TimMJN/Arduino-Euclidean-Rhythm-Generator/images/render_back.png

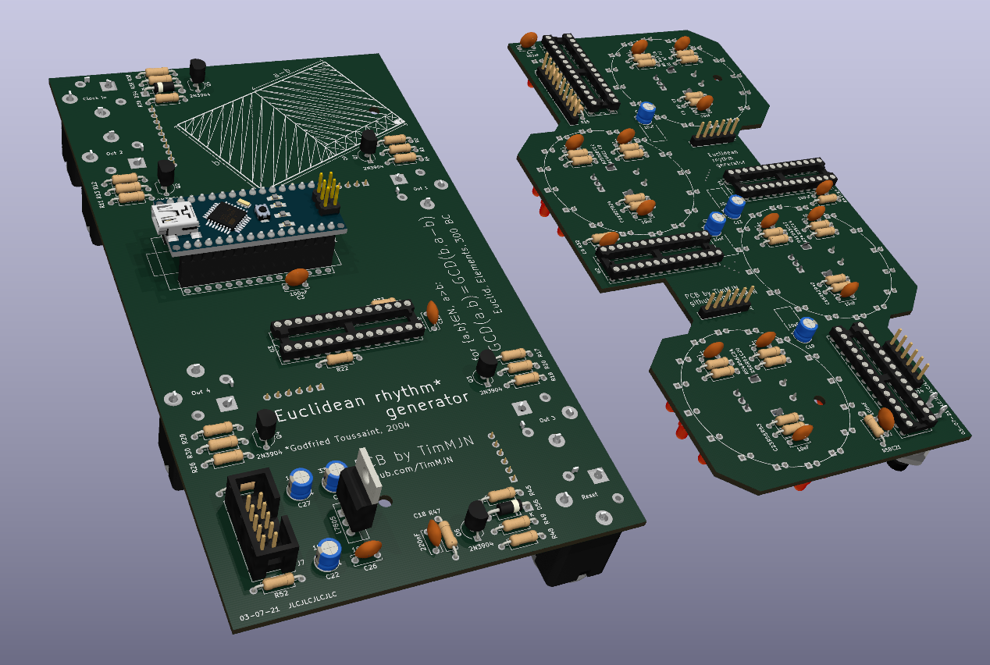
images/render_back.png
