TimMJN/Arduino-Euclidean-Rhythm-Generator/images/render_cv_expander_front.png

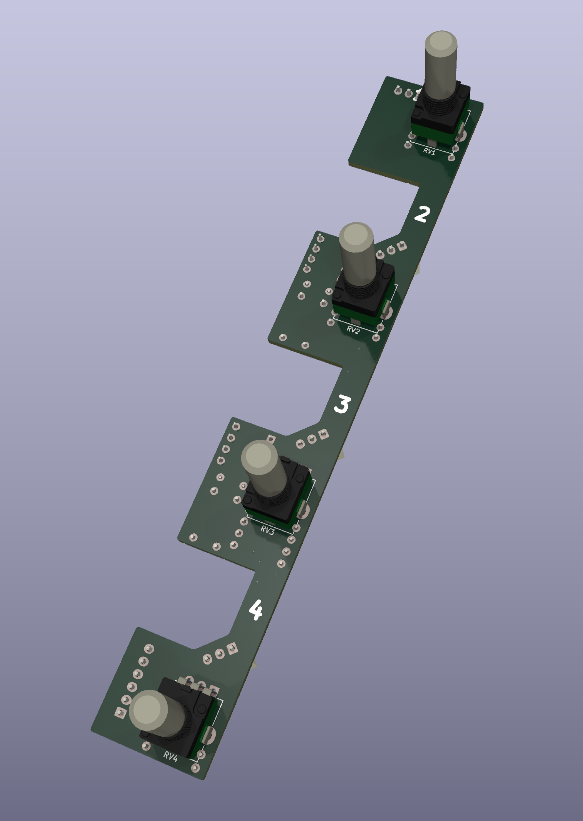
images/render_cv_expander_front.png
