TimMJN/Arduino-Euclidean-Rhythm-Generator/images/render_cv_expander_back.png

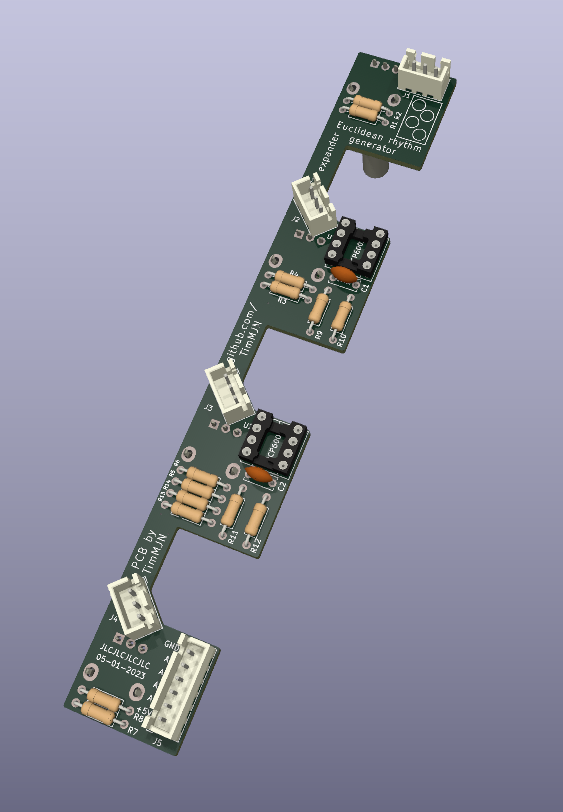
images/render_cv_expander_back.png
