TimMJN/Arduino-Euclidean-Rhythm-Generator/images/render_front.png

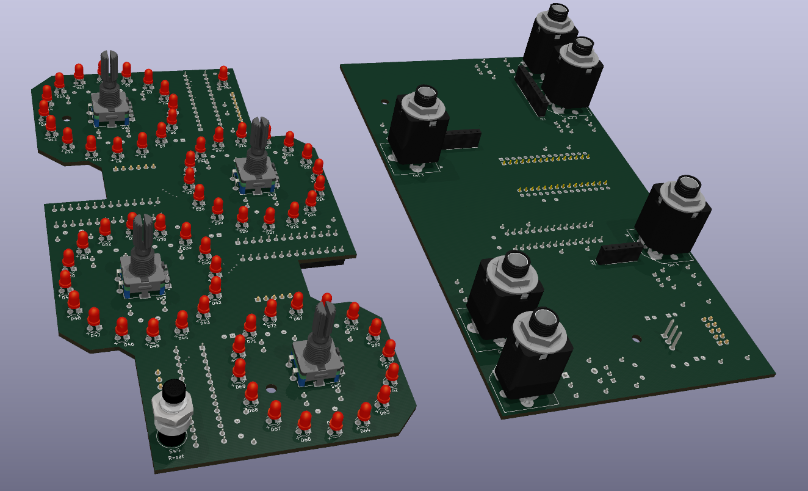
images/render_front.png
