TimMJN/Arduino-Euclidean-Rhythm-Generator/PCB/arduino_euclidean_rhythm_generator-PCB_back.png

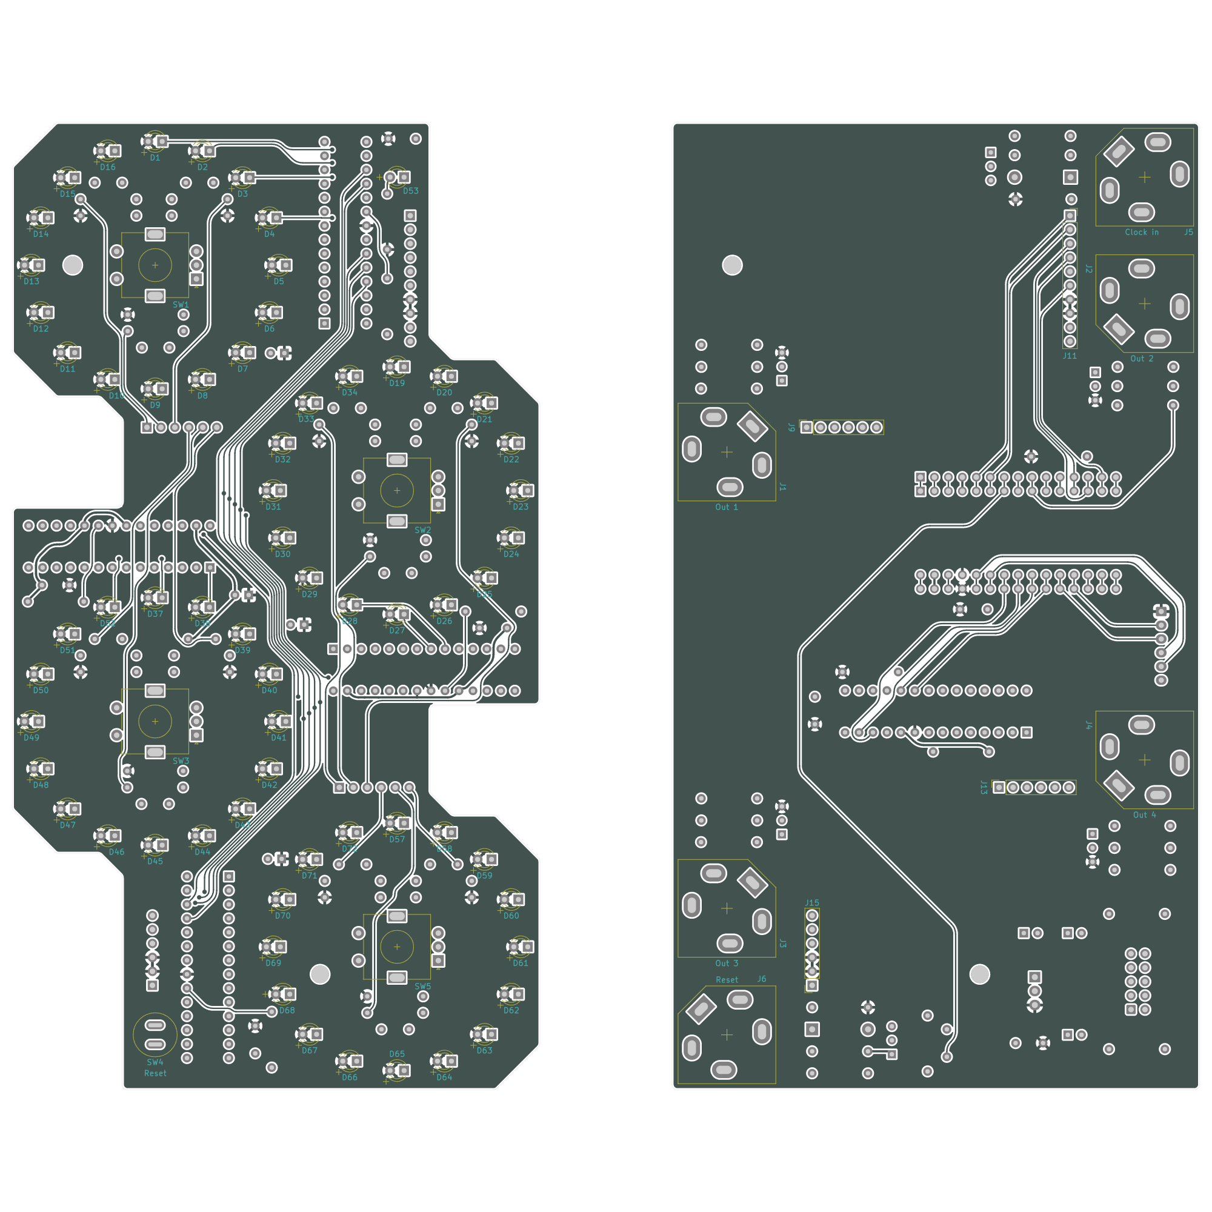
PCB/arduino_euclidean_rhythm_generator-PCB_back.png
