TimMJN/Arduino-Euclidean-Rhythm-Generator/PCB/arduino_euclidean_rhythm_generator-PCB_front.png

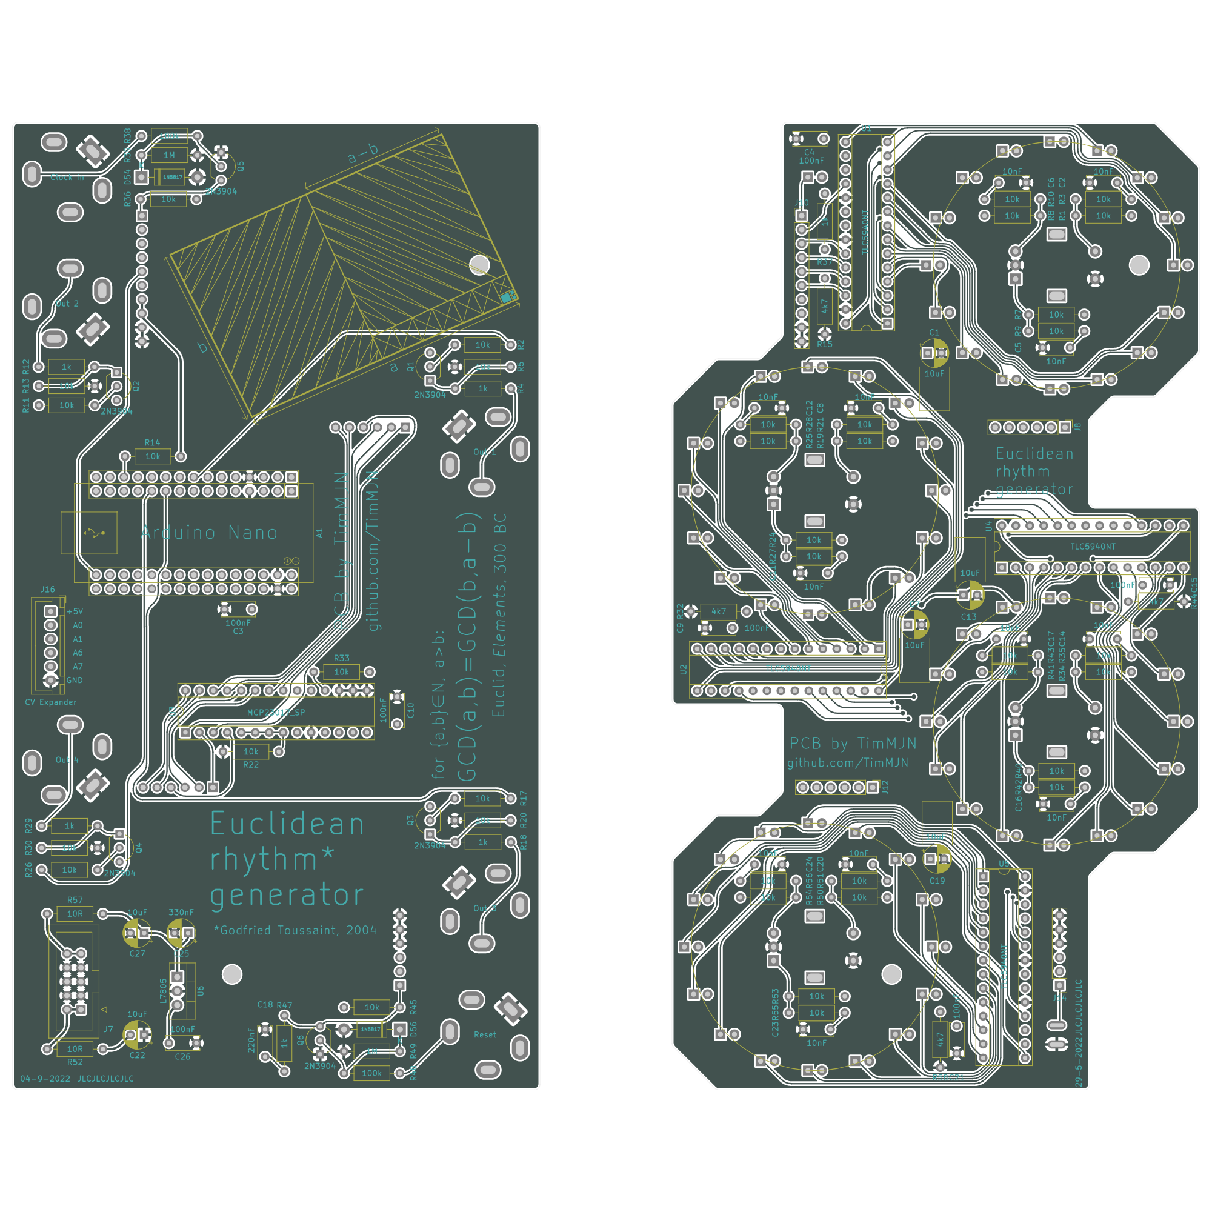
PCB/arduino_euclidean_rhythm_generator-PCB_front.png
