TimMJN/Arduino-Euclidean-Rhythm-Generator/schematic+BOM/arduino_euclidean_rhythm_generator.pdf

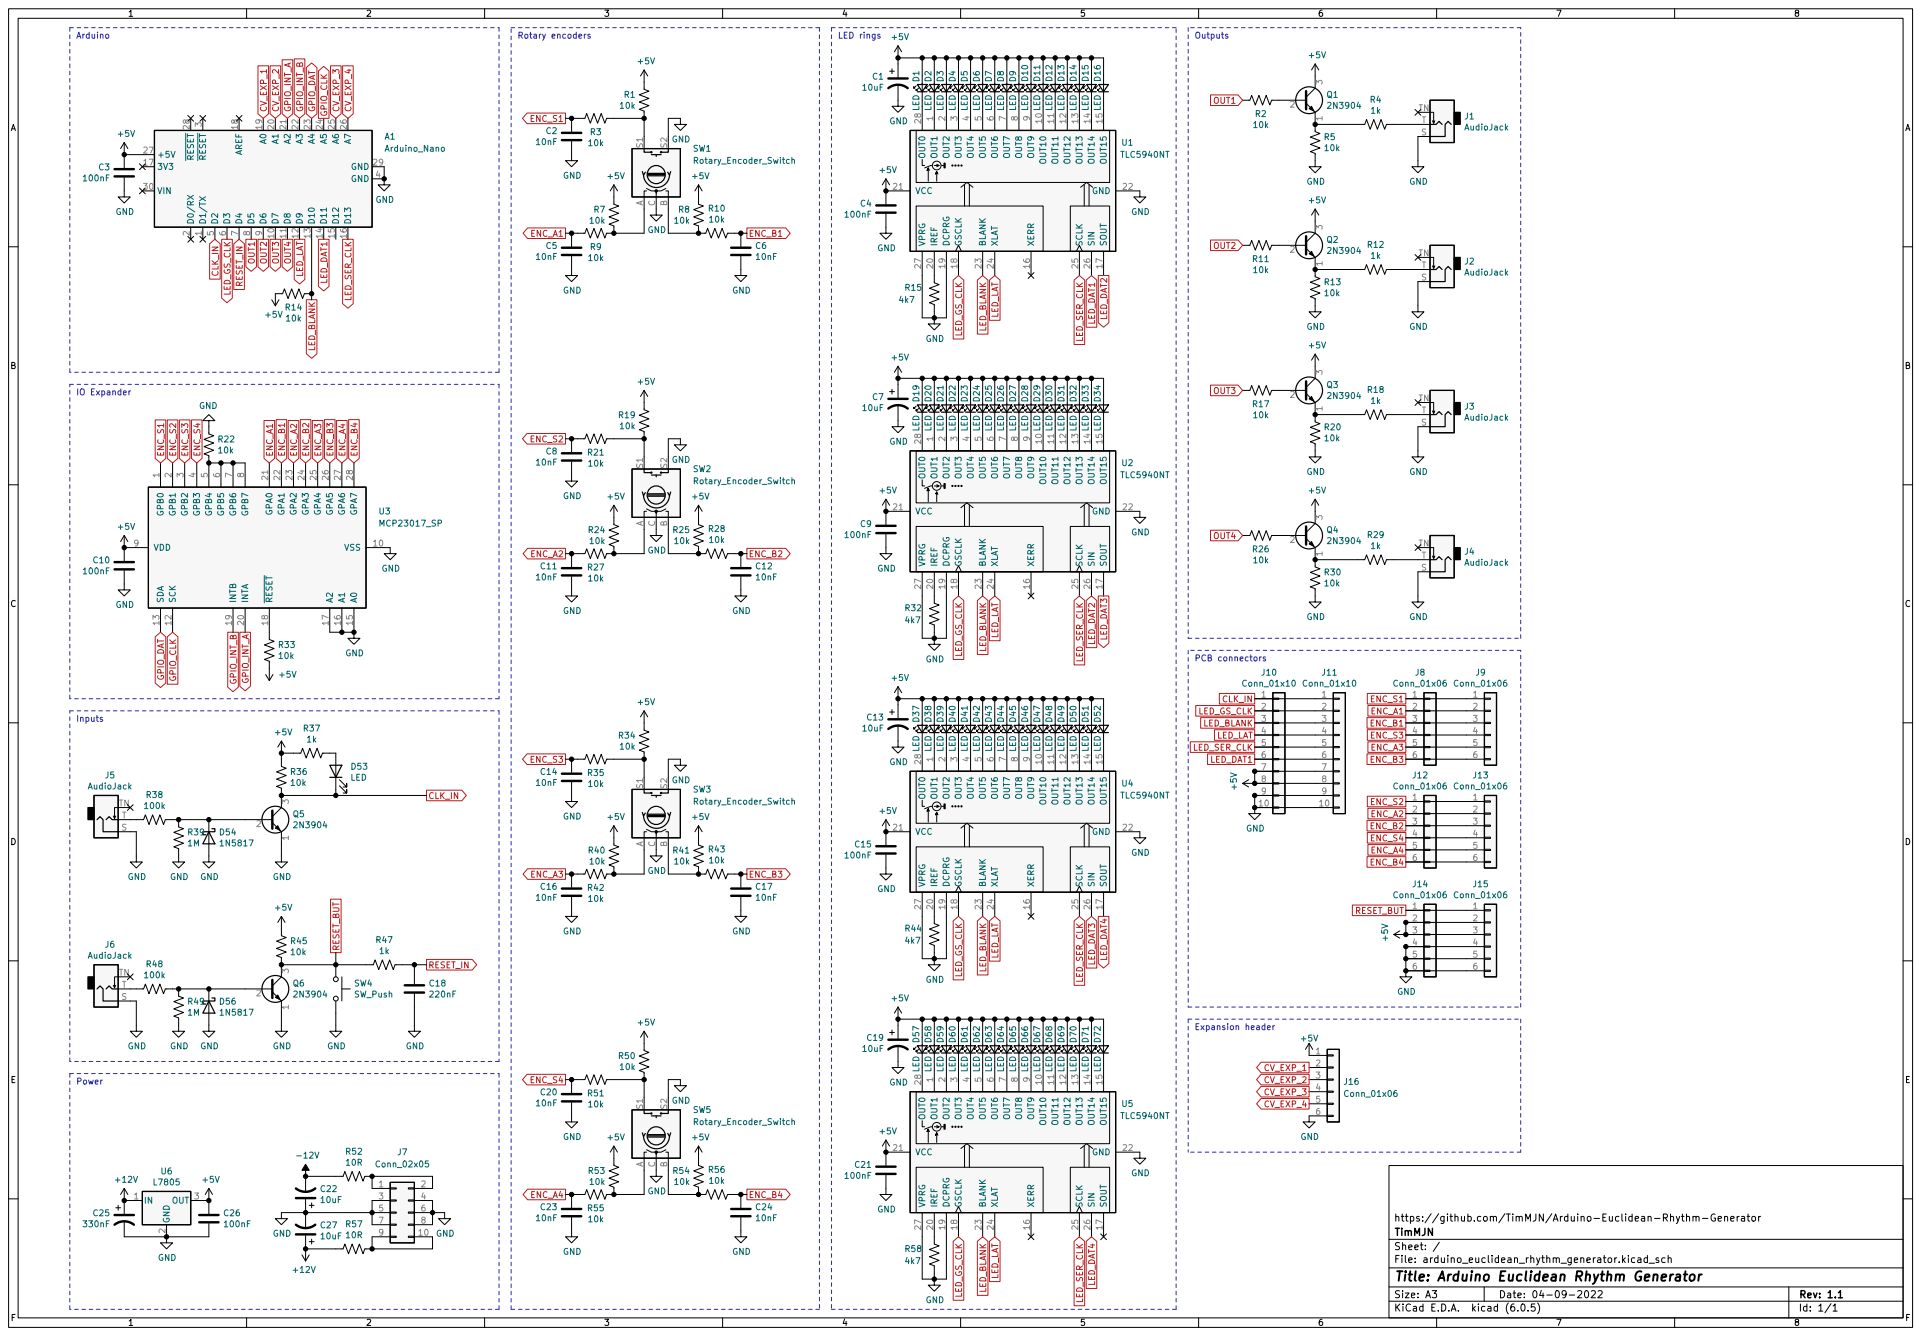
[picture p8: page 1]

https://github.com/TimMJN/Arduino-Euclidean-Rhythm-Generator
File: arduino_euclidean_rhythm_generator.kicad_sch Sheet: / TimMJN

Id: 1/1 Title: Arduino Euclidean Rhythm Generator
