TimMJN/Arduino-Euclidean-Rhythm-Generator/schematic+BOM/arduino_euclidean_rhythm_generator_BOM.pdf

Euclidean Rhythm Generator | Rev: 1.1
TimMJN | 04-09-2022

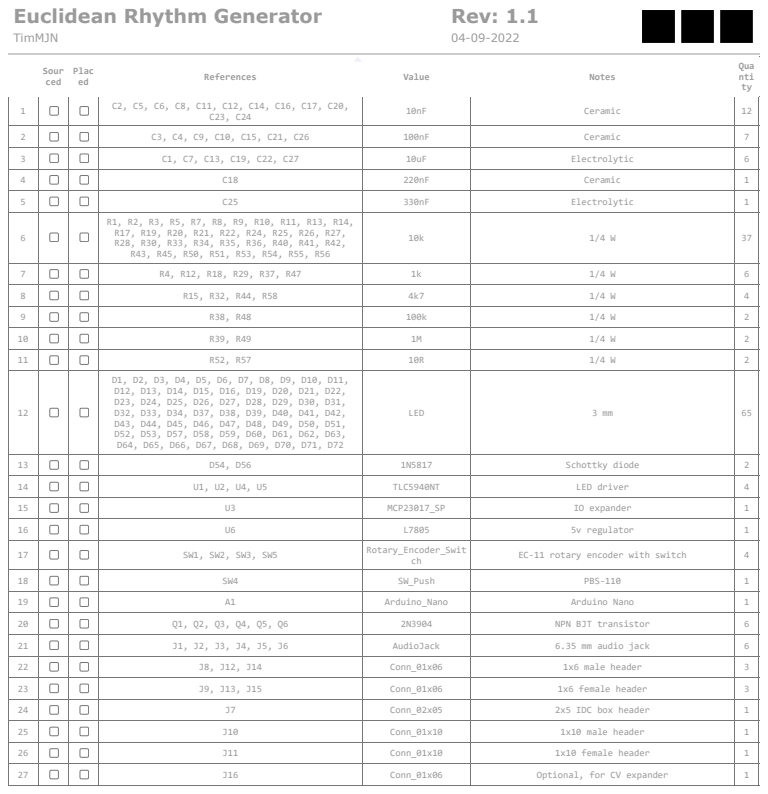
[picture p9: page 1]

Sour ced | Plac ed | References | Value | Notes | Qua nti ty

1 | | | C2, C5, C6, C8, C11, C12, C14, C16, C17, C20, C23, C24 | 10nF | Ceramic | 12

2 | | | C3, C4, C9, C10, C15, C21, C26 | 100nF | Ceramic | 7

3 | | | C1, C7, C13, C19, C22, C27 | 10uF | Electrolytic | 6

4 | | | C18 | 220nF | Ceramic | 1

5 | | | C25 | 330nF | Electrolytic | 1
6 | | | R1, R2, R3, R5, R7, R8, R9, R10, R11, R13, R14, R17, R19, R20, R21, R22, R24, R25, R26, R27, R28, R30, R33, R34, R35, R36, R40, R41, R42, R43, R45, R50, R51, R53, R54, R55, R56 | 10k | 1/4 W | 37

11 | | | R52, R57 | 10R | 1/4 W | 2
12 | | | D1, D2, D3, D4, D5, D6, D7, D8, D9, D10, D11, D12, D13, D14, D15, D16, D19, D20, D21, D22, D23, D24, D25, D26, D27, D28, D29, D30, D31, D32, D33, D34, D37, D38, D39, D40, D41, D42, D43, D44, D45, D46, D47, D48, D49, D50, D51, D52, D53, D57, D58, D59, D60, D61, D62, D63, D64, D65, D66, D67, D68, D69, D70, D71, D72 | LED | 3 mm | 65

13 | | | D54, D56 | 1N5817 | Schottky diode | 2

14 | | | U1, U2, U4, U5 | TLC5940NT | LED driver | 4

15 | | | U3 | MCP23017_SP | IO expander | 1

16 | | | U6 | L7805 | 5v regulator | 1
17 | | | SW1, SW2, SW3, SW5 | Rotary_Encoder_Swit ch | EC-11 rotary encoder with switch | 4

18 | | | SW4 | SW_Push | PBS-110 | 1

19 | | | A1 | Arduino_Nano | Arduino Nano | 1

20 | | | Q1, Q2, Q3, Q4, Q5, Q6 | 2N3904 | NPN BJT transistor | 6

21 | | | J1, J2, J3, J4, J5, J6 | AudioJack | 6.35 mm audio jack | 6

22 | | | J8, J12, J14 | Conn_01x06 | 1x6 male header | 3

23 | | | J9, J13, J15 | Conn_01x06 | 1x6 female header | 3

24 | | | J7 | Conn_02x05 | 2x5 IDC box header | 1

25 | | | J10 | Conn_01x10 | 1x10 male header | 1

26 | | | J11 | Conn_01x10 | 1x10 female header | 1

27 | | | J16 | Conn_01x06 | Optional, for CV expander | 1
