TimMJN/Arduino-Euclidean-Rhythm-Generator/schematic+BOM/arduino_euclidean_rhythm_generator_cv_expander_BOM.pdf

# Euclidean Rhythm Generator CV Expa… Rev: 1.1

TimMJN | 05-01-2023

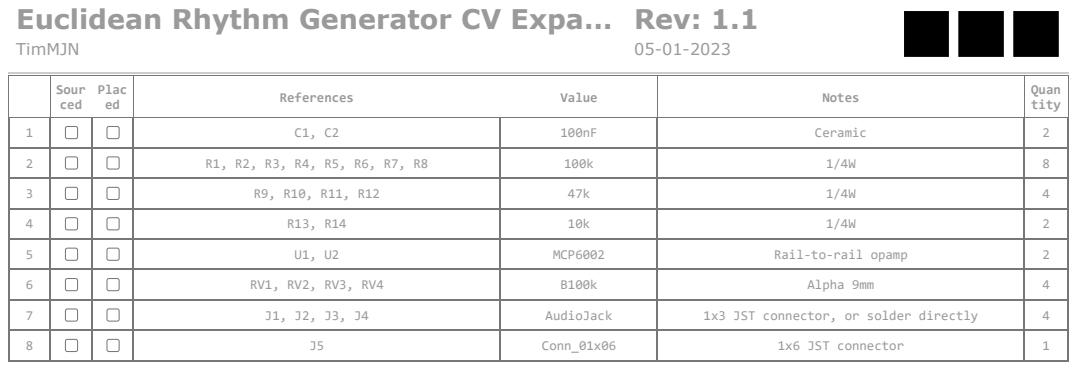
[picture p10: page 1]

Sour ced | Plac ed | References | Value | Notes | Quan tity

1 | | | C1, C2 | 100nF | Ceramic | 2

5 | | | U1, U2 | MCP6002 | Rail-to-rail opamp | 2

6 | | | RV1, RV2, RV3, RV4 | B100k | Alpha 9mm | 4

7 | | | J1, J2, J3, J4 | AudioJack | 1x3 JST connector, or solder directly | 4

8 | | | J5 | Conn_01x06 | 1x6 JST connector | 1
