TimMJN/Arduino-Euclidean-Rhythm-Generator/PCB/arduino_euclidean_rhythm_generator-Panel_drillguide.pdf

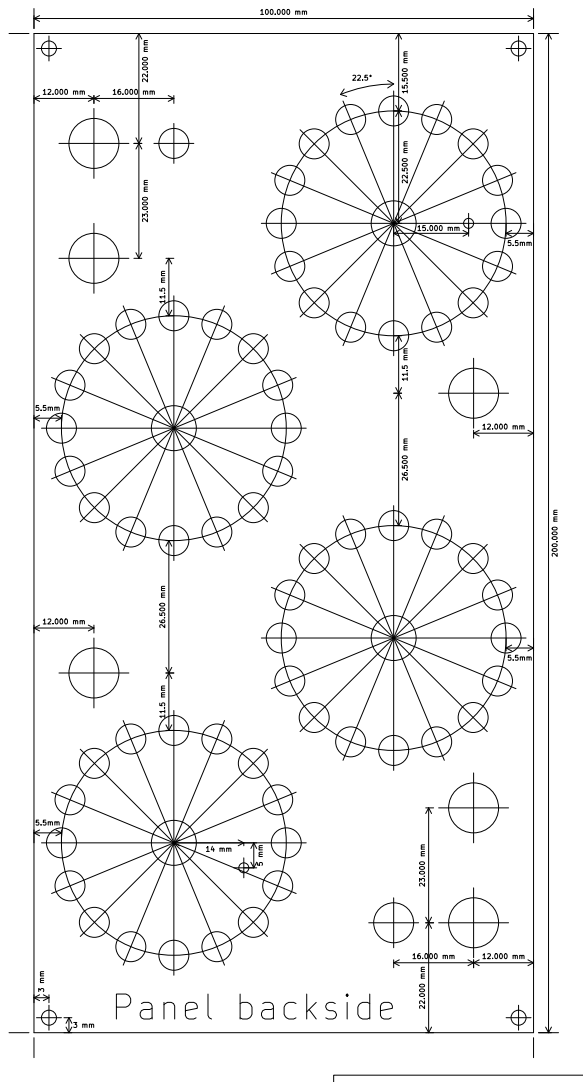
[picture p11: page 1]

github.com/TimMJN 3 mm

Id: 1/1 Title: Euclidean Rhythm Generator
