TimMJN/Arduino-Euclidean-Rhythm-Generator/PCB/arduino_euclidean_rhythm_generator_CV_expander-Panel_drillguide.pdf

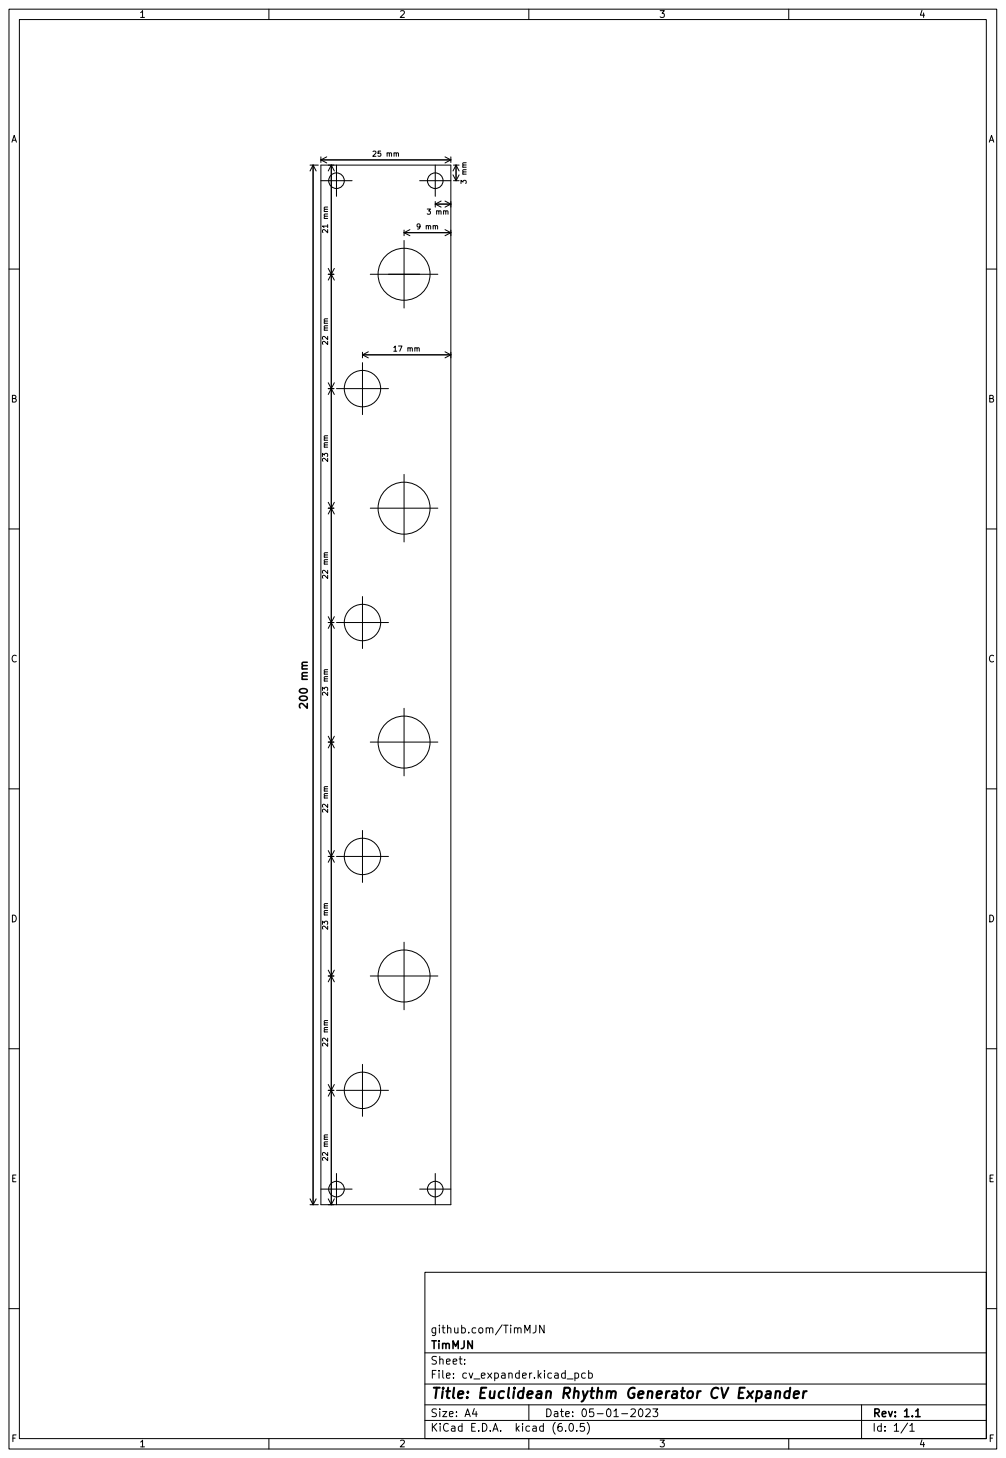
[picture p12: page 1]

Id: 1/1 Title: Euclidean Rhythm Generator CV Expander
