TimMJN/Arduino-Euclidean-Rhythm-Generator/schematic+BOM/arduino_euclidean_rhythm_generator_cv_expander.pdf

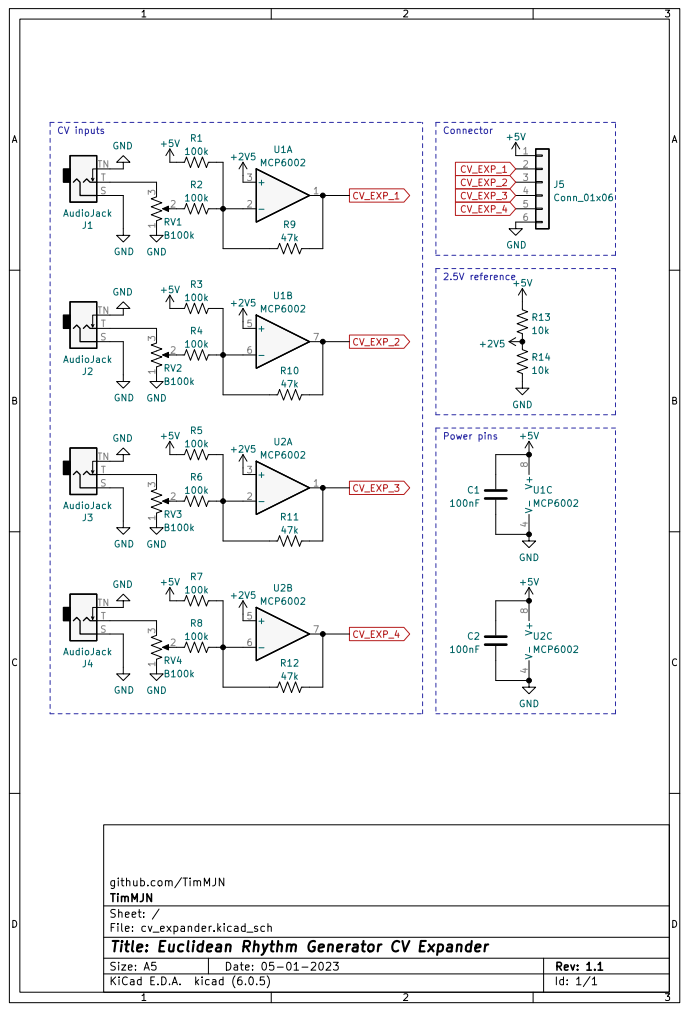
[picture p13: page 1]

Id: 1/1 Title: Euclidean Rhythm Generator CV Expander
