TimMJN/Arduino-Euclidean-Rhythm-Generator/(commit log)

2021-06-19 schematic update
2021-06-19 Update Adafruit-MCP23017-Arduino-Library
2021-07-24 added PCB files
2021-07-25 added BOM
2021-08-19 minor PCB update
2021-08-19 Added interactive BOM
2021-08-19 BOM update
2021-08-27 Update arduino_euclidean_rhythm_generator_firmware.ino
    more robust reading of encoders
2021-11-28 added dimensions to drill guide
2022-05-29 add pcb images
